joao-borrego/hw_sw/README.md

# Hardware Software Co-Design

_k_-NN Classification acceleration project for a Hardware Software Co-Design course.

For a detailed description of the implemented system refer to the reports under [docs/][1].

[1]: docs/
