joao-borrego/hw_sw/dataset/README.md

# Data sets

Two data sets were used for testing the correctness and benchmarking the performance.
Both of them are freely available at the [UCI Machine Learning Repository][1]:

1. [Iris Flower Data Set][2]
2. [Wine Quality Data Set][3]

[1]: https://archive.ics.uci.edu/ml/datasets/
[2]: https://archive.ics.uci.edu/ml/datasets/iris
[3]: https://archive.ics.uci.edu/ml/datasets/Wine+Quality
